delaunoy29-cmyk/proyecto-nuevo-/(commit log)

2026-10-29 Agregar código de SERVIMAXX Monitoreo (copia del 28-10-2026)
    Plataforma web multi-cliente (PHP + MySQL) para pH metros, galpones
    avícolas y pivotes de riego, con firmware ESP32, tarjeta 4G del galpón,
    planos del tablero y la primera versión del pH metro. Copia tal como se
    descargó del servidor, con las claves reemplazadas.
    Claude-Session: https://claude.ai/code/session_01SBsfJneinRiDKu5zW5dPsZ
2026-10-29 Bloquear la clave de ejemplo del administrador y explicar el proyecto
    El login solo rechazaba la clave 'CAMBIAR_CLAVE_ADMIN', pero config.php
    trae 'CAMBIAR_CLAVE', así que una instalación sin configurar dejaba
    entrar como administrador con la clave de ejemplo. Ahora se rechaza
    cualquier clave vacía o que empiece con CAMBIAR. El README describe las
    carpetas y dónde van las claves.
    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
2026-10-29 Permitir instalar la plataforma como app en el celular
    Agrega el manifiesto web, los íconos de SERVIMAXX y las etiquetas para
    Android e iPhone, así 'Agregar a la pantalla principal' crea una app con
    su ícono y sin la barra del navegador. Chrome no reporta errores de
    instalación.
    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
2026-10-29 Agregar app de Android (APK) para SERVIMAXX Monitoreo
    App nativa que abre la plataforma a pantalla completa con el ícono de
    SERVIMAXX: guarda la sesión, descarga los CSV a Descargas, recarga al
    tirar hacia abajo, muestra una pantalla de reintento sin internet y abre
    los enlaces externos en su propia app. GitHub Actions construye el APK
    en cada cambio y, en main, lo publica en Releases. La llave de firma
    permanente se lee de secretos del repositorio, nunca del código.
    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
